JoshKing56/8-Bit-Computer/README.md

# BB8: The 8-bit bread board computer

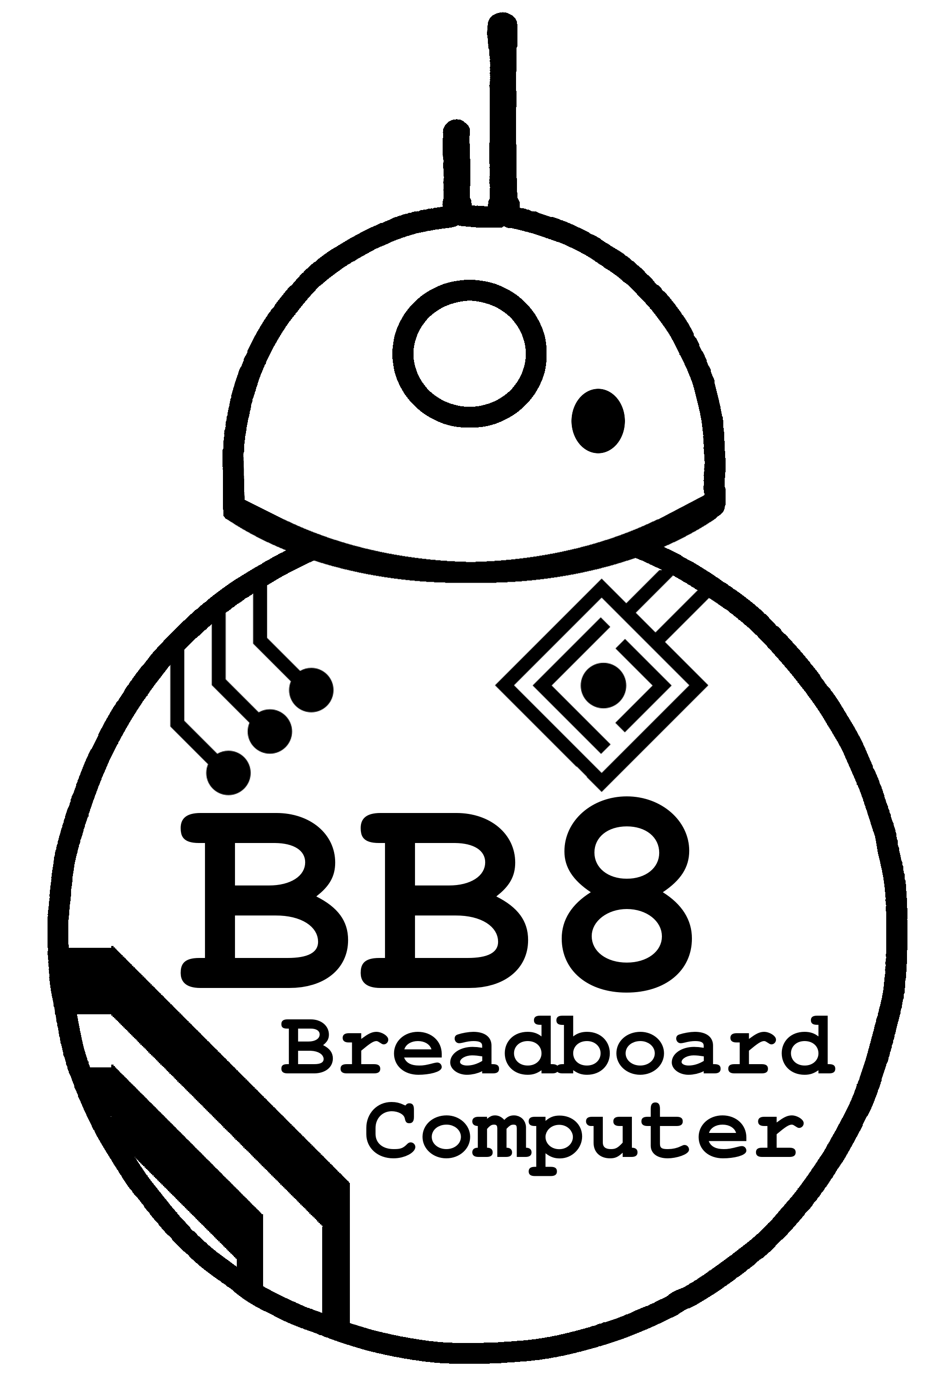
[picture p1: resources/BB8_ver3.png]


## What is this? ##
BB8 is a fully functional, turing complete Von Neumann based archetecture designed for breadboards.

This project was inspired by, a similar project done by [Ben Eater](https://www.youtube.com/user/eaterbc)

## How do I use this? ##
For information, documentation, and examples, [check the wiki](https://github.com/JoshKing56/8-Bit-Computer/wiki)

## Authors

* **Josh King** - *Developer* - [Github](https://github.com/ridgeontheway)
* **Chris Hill** - *Architect* - [Github](https://github.com/Chris-j-hill)
* **Connor Foy** - *Designer* - [Github](https://github.com/ConorFoy)

## License

This project is licensed under the MIT License - see the [LICENSE](LICENSE) file for details
