JoshKing56/8-Bit-Computer/(list of files, drawings)

Other design files:
Logisim/legacy/version-1.circ
Logisim/legacy/version-2.circ
Logisim/legacy/version-C.circ
Logisim/old/version 2.circ
Logisim/old/version-1.circ
Logisim/old/version-C.circ
Logisim/old/version-Display.circ
Logisim/version 2.circ
Logisim/version-1.circ
Logisim/version-C.circ
Logisim/version-CF-DisplayCircuit.circ
Logisim/version-CF.circ
Logisim/version-CH2.circ
Logisim/version-CH3.circ
Logisim/version-CH.circ
version 2.circ
version-1.circ
version-C.circ
