JoshKing56/8-Bit-Computer/Arduino Code/ISRBlink/ISRBlink.ino

//timer library: https://code.google.com/archive/p/arduino-timerone/downloads
#include <TimerOne.h>



//byte temp = 0;
void setup()
{
  // Initialize the digital pin as an output.
  // Pin 13 has an LED connected on most Arduino boards
  pinMode(13, OUTPUT);

  Timer1.initialize(10); // set a timer of length 100000 microseconds (or 0.1 sec - or 10Hz => the led will blink 5 times, 5 cycles of on-and-off, per second)
  Timer1.attachInterrupt( timerIsr ); // attach the service routine here
}

void loop()
{
  // Main code loop
  // TODO: Put your regular (non-ISR) logic here
}

/// --------------------------
/// Custom ISR Timer Routine
/// --------------------------
void timerIsr()
{
  // Toggle LED
  //
  static byte temp = 0;
  if (temp == 1) { //Turn LED on.
    PORTB = B00000000; //Turn LED off.
    temp = 0;
  }
  else {
    PORTB = B00100000;
    temp = 1;
  }
}
