JoshKing56/8-Bit-Computer/(commit log)

2018-03-26 init add
    [version 2.circ, version-1.circ, version-C.circ]
2018-03-26 organization again
    [version 2.circ, version-1.circ, version-C.circ]
2018-03-26 alu changes
    [version 2.circ, version-1.circ, version-C.circ]
2018-03-27 Auto stash before merge of "master" and "origin/master"
    [version-1.circ]
2018-03-27 moved logisim
    [version-1.circ]
2018-03-27 Add instruction control logic done and instruction documentation updated
    [version-1.circ]
2018-03-28 Arduino CLock code
2018-03-30 logism and word doc update
    [version-1.circ]
2018-03-31 misc instructions re organised
    [version-1.circ]
2018-03-31 logical comaprison done and display module integrated
    [version-1.circ]
2018-03-31 Control provisionally done and instruction set documentation complete
    [version-1.circ]
2018-03-31 removed clear interrupt register instruction
    [version-1.circ]
2018-04-01 Added LED matrix, Added LED outputs
    Replaced separate LEDs with 8x16 matrix and added outputs of the LED data so a LED matrix can be attached directly to the module in Main
    [version-1.circ]
2018-04-01 OCL register implemented
    [version-CH.circ]
2018-04-01 Fixed RAM and Display
    [version-CF.circ]
2018-04-03 instruction set update
    [version 2.circ, version-1.circ, version-C.circ]
2018-04-03 final logisim
    [version-CF.circ, version-CH.circ]
2018-04-03 FIxed PC and MUX Main
    [version-CH.circ]
2018-04-03 LD fix and reg write inversion
    [version-CH.circ]
2018-04-03 mux 2 error
    [version-CH.circ]
2018-04-03 wiring error
    [version-CH.circ]
2018-04-04 fixed ram connection
    [version-CH.circ]
2018-04-04 overclock register finished
    [version-CH.circ]
2018-04-04 changed word doc tables
    [version-CH.circ]
2018-04-04 fixed RSH control line
    [version-CH.circ]
2018-04-04 Print formatting
2018-04-05 Added folder of test codes, Flipped display data and adddress lines
    [version-CF.circ]
2018-04-05 Hex printing now works
2018-04-07 fixed ocl splitter wiring and read 1 and gates
    [version-CH.circ]
2018-04-07 z fixed and instruction set doc updated
    [version-CH.circ]
2018-04-08 logical operations fixed and doc updated
    [version-CH.circ]
2018-04-08 Fixed ALU logic
    [version-CF.circ, version-CH.circ]
2018-04-09 main arduino code initial commit
2018-04-09 function prototypes done and interrupts attached
2018-04-10 set interrupts done
    [version-CH.circ]
2018-04-10 small arduino code update
2018-04-10 doc update again
    [version-CH.circ]
2018-04-11 display driver and dual clocks done
    [version-CH.circ]
2018-04-13 addition fix
    [version-CH.circ]
2018-04-13 Addition FIx v2
    [version-CH.circ]
2018-04-13 Fixed CF version
    [version-CF.circ]
2018-04-13 Added 16input mux
    [version-CF.circ]
2018-04-13 Finished 8bit 16input multiplexer
    [version-CF.circ]
2018-04-13 Added 8bit 3, 5, 6 multiplexers
    [version-CH2.circ]
2018-04-15 rewired control and tested, minor doc updates
    [version-CH2.circ]
2018-04-15 more rewiring because I cant count
    [version-CH2.circ]
2018-04-16 created gpio module and 16 channel write mux
    [version-CH2.circ]
2018-04-16 fixed wiring, bubble sort working again
    [version-CH2.circ]
2018-04-17 fix 2s complement gr
    [version-CH2.circ]
2018-04-18 write mux acccepting io lines adn doc updated
    [version-CH2.circ]
2018-04-18 Updated Input
    [version-CH2.circ]
2018-04-23 PLU disable interrupts implemented i think
    [version-CH2.circ]
2018-04-23 Added circular shift to ALU and Documentation
    [version-CF.circ]
2018-04-23 Added circular shift to control - not tested
    [version-CF.circ]
2018-04-24 Prettuy printing
2018-04-25 Tested ROL, ROR
    [version-CF.circ]
2018-05-06 due speed test code
    [version-CH2.circ]
2018-05-13 Added addr filter to Display circuit, Started on BB8 animation
    Display was just looking at the lower 4 bits so if you saved to addr 16 it would also be written to the addr 0
    [version-CF.circ]
2018-05-21 changed clock line
    [version-CF.circ]
2018-05-21 Packaged Interrupt block
    [version-CF.circ]
2018-05-21 Updated Interrupts
    [version-CF.circ]
2018-05-21 !!!!!!! RAM CHANGE !!!!!!!!
    [version-CF.circ]
2018-07-28 Added display circiut, Added datasheets
    [version-CF-DisplayCircuit.circ, version-CF.circ]
2018-08-11 added test arduino code for display counter
    [version-CF-DisplayCircuit.circ]
2018-10-10 some updates
    [control LUT generator.xlsx, version-CH3.circ]
2018-10-11 first two instructions working
    [control LUT generator.xlsx]
2018-10-11 add reg in control for SIR instruction and update docs
    [control LUT generator.xlsx, version-CH3.circ]
2018-10-11 ld instructions working
    [control LUT generator.xlsx, version-CH3.circ]
2018-10-11 CLR working, changed python CLR binary
    [version-CH3.circ]
2018-10-13 adds and subtracts implemented
    [control LUT generator.xlsx, version-CH3.circ]
2018-10-13 all instructions implemented
    [control LUT generator.xlsx, version-CH3.circ]
2018-10-13 fix excel doc
    [control LUT generator.xlsx]
2018-10-13 4bit 16ch mux pcb
2018-10-14 added register selector demultiplexer
    [version-CH3.circ]
2018-10-15 added page reg clear, ocl reg clear, not2s, interrupt config reg
    [version-CH3.circ]
2018-10-15 fixed instruction mapping doc typos
    [control LUT generator.xlsx]
